mattzzw/midi_muppet_hx_2btn/(commit log)

2020-05-18 Adds LED notification on long press up
2020-05-18 Removes debug led flashing
2020-05-24 Adds bicolor LED
2020-05-24 Improves mode indication by LEDs
2020-05-25 Last mode is stored in EEPROM
    Scroll, snapshot and FS mode are now stored in EEPROM so that on next
    power up the same mode is active. Closes #1
2020-05-25 Restore saved mode on power up and send midi commands accordingly
2020-05-26 Fix late night typo, add red LED brighness compensation (mine was too bright)
    [midi_muppet_hx_2btn.ino]
2020-05-26 Add LOOPER mode, select mode while holding button on power up, FS mode is a separate mode now
2020-05-26 FS mode is indicated with a solid green LED in operation
2020-05-26 Fix reloading last used mode on boot up
    [midi_muppet_hx_2btn.ino]
2020-05-27 Add mode switching by pressing and holding both buttons
2020-05-27 Using yellow LED for Overdub, tuner mode also possible in FS mode
2020-05-27 Code cleanup, update README regarding switch handling
2020-06-07 Fix button handling for looper mode
    [midi_muppet_hx_2btn.ino]
2020-06-07 In LOOPER mode record and overdub will start with a down press of the button
2020-06-07 Fix README (button assignment, library requirements)
2020-08-02 Add info for using 3.3V version of Aduino Pro Mini
2021-04-26 Align configuration button scheme for MIDI and looper config
